MirzaAmman582/Hybrid-VTOL-Ground-Air-Rover/Firmware/Hybrid_Rover_PX4_Parameters.param

ATC_ANG_LIM_TC,1
ATC_ANG_PIT_P,4.5
ATC_ANG_RLL_P,4.5
ATC_ANG_YAW_P,4.5
ATC_ANGLE_BOOST,1
ATC_RAT_PIT_D,0.0036
ATC_RAT_PIT_D_FF,0
ATC_RAT_PIT_FF,0
ATC_RAT_PIT_FLTD,20
ATC_RAT_PIT_FLTE,0
ATC_RAT_PIT_FLTT,20
ATC_RAT_PIT_I,0.135
ATC_RAT_PIT_IMAX,0.5
ATC_RAT_PIT_P,0.135
ATC_RAT_PIT_PDMX,0
ATC_RAT_PIT_SMAX,0
ATC_RAT_RLL_D,0.0036
ATC_RAT_RLL_D_FF,0
ATC_RAT_RLL_FF,0
ATC_RAT_RLL_FLTD,20
ATC_RAT_RLL_FLTE,0
ATC_RAT_RLL_FLTT,20
ATC_RAT_RLL_I,0.135
ATC_RAT_RLL_IMAX,0.5
ATC_RAT_RLL_P,0.135
ATC_RAT_RLL_PDMX,0
ATC_RAT_RLL_SMAX,0
ATC_RAT_YAW_D,0
ATC_RAT_YAW_D_FF,0
ATC_RAT_YAW_FF,0
ATC_RAT_YAW_FLTD,20
ATC_RAT_YAW_FLTE,2.5
ATC_RAT_YAW_FLTT,20
ATC_RAT_YAW_I,0.018
ATC_RAT_YAW_IMAX,0.5
ATC_RAT_YAW_P,0.18
ATC_RAT_YAW_PDMX,0
ATC_RAT_YAW_SMAX,0
ATC_RATE_FF_ENAB,1
ATC_RATE_P_MAX,0
ATC_RATE_R_MAX,0
ATC_RATE_Y_MAX,0
BATT_AMP_OFFSET,0
BATT_AMP_PERVLT,17
BATT_ARM_MAH,0
BATT_ARM_VOLT,0
BATT_CAPACITY,3300
BATT_CRT_MAH,0
BATT_CRT_VOLT,0
BATT_CURR_PIN,3
BATT_FS_CRT_ACT,0
BATT_FS_LOW_ACT,0
BATT_FS_VOLTSRC,0
BATT_LOW_MAH,0
BATT_LOW_TIMER,10
BATT_LOW_VOLT,10.5
BATT_MONITOR,4
BATT_OPTIONS,0
BATT_SERIAL_NUM,-1
BATT_VLT_OFFSET,0
BATT_VOLT_MULT,10.1
BATT_VOLT_PIN,2
BATT2_MONITOR,0
BATT3_MONITOR,0
BATT4_MONITOR,0
BATT5_MONITOR,0
BATT6_MONITOR,0
BATT7_MONITOR,0
BATT8_MONITOR,0
BATT9_MONITOR,0
FLTMODE_CH,5
FLTMODE_GCSBLOCK,0
FLTMODE1,0
FLTMODE2,0
FLTMODE3,0
FLTMODE4,0
FLTMODE5,0
FLTMODE6,0
FRAME_CLASS,1
FRAME_TYPE,1
INS_GYRO_FILTER,20
INS_HNTCH_ENABLE,0
MOT_BAT_CURR_MAX,0
MOT_BAT_CURR_TC,5
MOT_BAT_IDX,0
MOT_BAT_VOLT_MAX,0
MOT_BAT_VOLT_MIN,0
MOT_BOOST_SCALE,0
MOT_HOVER_LEARN,2
MOT_OPTIONS,0
MOT_PWM_MAX,2021
MOT_PWM_MIN,1016
MOT_PWM_TYPE,0
MOT_SAFE_DISARM,0
MOT_SAFE_TIME,1
MOT_SLEW_DN_TIME,0
MOT_SLEW_UP_TIME,0
MOT_SPIN_ARM,0.12
MOT_SPIN_MAX,0.95
MOT_SPIN_MIN,0.15
MOT_SPOOL_TIM_DN,0
MOT_SPOOL_TIME,0.5
MOT_THST_EXPO,0.65
MOT_THST_HOVER,0.35
MOT_YAW_HEADROOM,200
SERIAL0_BAUD,115
SERIAL0_PROTOCOL,2
SERIAL1_BAUD,57
SERIAL1_OPTIONS,0
SERIAL1_PROTOCOL,2
SERIAL2_BAUD,57
SERIAL2_OPTIONS,0
SERIAL2_PROTOCOL,2
SERIAL3_BAUD,230
SERIAL3_OPTIONS,0
SERIAL3_PROTOCOL,5
SERIAL4_BAUD,230
SERIAL4_OPTIONS,0
SERIAL4_PROTOCOL,5
SERIAL5_BAUD,57
SERIAL5_OPTIONS,0
SERIAL5_PROTOCOL,-1
SERVO1_FUNCTION,33
SERVO1_MAX,1900
SERVO1_MIN,1100
SERVO1_REVERSED,0
SERVO1_TRIM,1500
SERVO2_FUNCTION,34
SERVO2_MAX,1900
SERVO2_MIN,1100
SERVO2_REVERSED,0
SERVO2_TRIM,1500
SERVO3_FUNCTION,35
SERVO3_MAX,1900
SERVO3_MIN,1100
SERVO3_REVERSED,0
SERVO3_TRIM,1500
SERVO4_FUNCTION,36
SERVO4_MAX,1900
SERVO4_MIN,1100
SERVO4_REVERSED,0
SERVO4_TRIM,1500
SERVO5_FUNCTION,0
SERVO5_MAX,1900
SERVO5_MIN,1100
SERVO5_REVERSED,0
SERVO5_TRIM,1500
SERVO6_FUNCTION,0
SERVO6_MAX,1900
SERVO6_MIN,1100
SERVO6_REVERSED,0
SERVO6_TRIM,1500
SERVO7_FUNCTION,0
SERVO7_MAX,1900
SERVO7_MIN,1100
SERVO7_REVERSED,0
SERVO7_TRIM,1500
SERVO8_FUNCTION,0
SERVO8_MAX,1900
SERVO8_MIN,1100
SERVO8_REVERSED,0
SERVO8_TRIM,1500
SERVO9_FUNCTION,0
SERVO9_MAX,1900
SERVO9_MIN,1100
SERVO9_REVERSED,0
SERVO9_TRIM,1500
