MirzaAmman582/Hybrid-VTOL-Ground-Air-Rover/hybrid_rover.jpeg

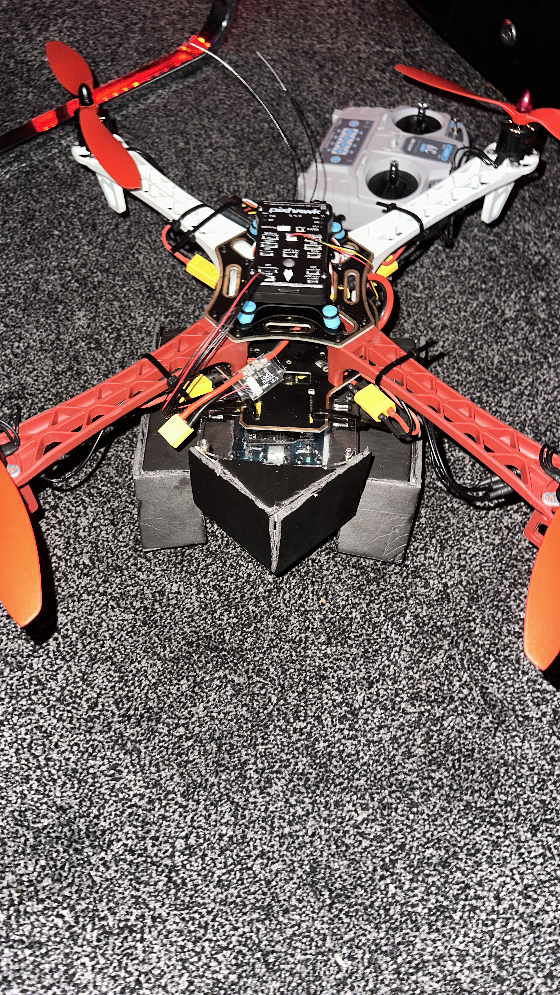
[picture p1: hybrid_rover.jpeg]
hybrid_rover.jpeg
